anismaddi/Teensy-Controller/(commit log)

2025-11-23 Create ADC
2025-11-23 Update analog input resolution and SPI settings
    Changed analog input resolution and SPI speed.
2025-11-23 Refactor ADC sampling and SPI transfer logic
    Updated ADC sampling method and SPI communication for MCP4822.
